bl1ndc4m3l/sdc-ntc-emulator/HANDOFF_SDC_NTC_Emulator.md

# Handoff: Wireless Room Sensor for Honeywell Home Smile SDC via NTC Emulation

> **⏰ Pending checks (user):**
> 1. **DevKit diode check:** Are there Schottky diodes (1N5819 or similar) between each USB-C VBUS and the 5 V rail on the clone board? This decides whether USB and RAC03 may be connected at the same time.
>
> Details under [Open points](#open-points-clarify-before-starting).

## Goal

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

## Installed hardware

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

Datasheets and manuals are kept locally in `datasheets/` (not in git, `*.pdf` is ignored). The authoritative SDC documents are the English Resideo set for the SDC3-40PM, revision R1020, valid for software V3.2:

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

The other German `SDC_*.pdf` files (2006–2008) are older revisions and only kept for reference.

## Context from the preliminary discussion

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

## Circuit (revision 3, PCB rev 2 after the independent review of 2026-09-30)

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

```
  LIVING ROOM                       HOME ASSISTANT                 BOILER ROOM
 ┌────────────────┐   Wi-Fi     ┌─────────────────┐  ESPHome API  ┌──────────────────────┐
 │ NSPanel-EU     │ ──────────▶ │ entity "Anzeige"│ ────────────▶ │ ESP32-S3 DevKitC-1   │
 │ (ESPHome)      │             └─────────────────┘               └──────────────────────┘

            ESP DOMAIN (RAC03 secondary / USB / PC)  ┆  SDC DOMAIN (floating, referenced to X5 only)
                                                     ┆
 230 V ─ fuse ─▶ RAC03 ─ 5 V ─▶ Q2 P-FET (reverse-polarity protection) ─ +5V
                              ┌───────────────────────────────────────────┘
                              ├─▶ DevKit 5V pin      ┆
                              ├─▶ iso DC/DC in ══════╪═▶ TMR 1-0511  5V = VDD_ISO ─┬─▶ AD5272 VDD
                              │                      ┆                             └─▶ ISO1540 side 2
      DevKit 3V3 ─▶ ISO1540 side 1                   ┆
      GPIO8/9 SDA/SCL ─▶ ISO1540 ════════════════════╪═▶ SDA2/SCL2 ─▶ AD5272 (addr 0x2F)
                              └─▶ relay coil ◀─ MOSFET ◀─ GPIO4 "ENABLE" (pull-down)
                                   ║            └─ 10k/20k divider ─▶ GPIO5 "SENSE" (LOW = coil on)
                                   ║ (coil/contact isolation)
              ┌─ relay (G5V-2, both poles in parallel, gold contacts) ───────────┐
 X6-6 (VE1) ──┤ COM                                                              │
              │   NO (energised) ── R_series 18.2 kΩ 0.1 % ── W ┤AD5272 50k├ A ──┼──┐
              │   NC (no power)  ── R_failsafe 24.9 kΩ 0.1 % ────────────────────┼──┤
              └──────────────────────────────────────────────────────────────────┘  │
 X5-2…12 (GND, never X5-1) ─────────────────────────────── GND_ISO (AD5272, ISO1540-2) ┘
```

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

**Gap on the PCB: ≥ 1.40 mm copper-to-copper**, measured on the finished board by `tools/check_isolation.py` (build fails below 1.0 mm).
- **Rev 3:** the gap is one straight line through PS1, U1 and U3, plus one step around the relay contacts. The Traco TMR 1-0511 (SIP-6) has its input at one end and its output at the other, with 3.6 mm of copper between them.
- **History:** the earlier TEM 2-0511 (DIP-24) put −Vin (pin 12) next to +Vout (pin 11).
  - That forced a notch into the gap; its tightest spot was 1.15 mm in rev 2.
  - Rev 1 claimed "≥ 1 mm" but actually had 0.40 mm there (found by the review).
  - Since rev 2 the router keeps whole tracks, not just their centre lines, inside their domain.

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

### Why each part is there

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

### Bill of materials

| Part | Purpose | Note |
|---|---|---|
| ESP32-S3-DevKitC-1 (WROOM-1 N16R8) | Receives room temp., drives rheostat and relay | powered via its 5V pin from the RAC03 |
| AD5272BRMZ-50 (MSOP-10, soldered directly on the PCB) | digital rheostat, 50 kΩ, 1024 steps, I2C | needs 1 µF on EXT_CAP, 100 nF on VDD, RESET tied to VDD, ADDR → GND = I2C address 0x2F |
| Resistor 18.2 kΩ, 0.1 %, ≤ 25 ppm/K, THT | R_series (R9) | |
| Resistor 24.9 kΩ, 0.1 %, ≤ 25 ppm/K, THT | R_failsafe (R10) | value = NTC resistance at the SDC day setpoint, minus the +0.5 K display offset |
| **Omron G5V-2-H1 5VDC** (DPDT, both poles in parallel) | fail-safe switch-over | gold-alloy contacts, coil 30 mA / 167 Ω; Reichelt; PCB holes 1.0 mm as Omron recommends |
| AO3400A, 100 kΩ, 100 Ω, 1N4148W | relay driver | |
| 10 kΩ + 20 kΩ | relay sense divider to GPIO5 | |
| AO3401A P-FET | reverse-polarity protection | |
| ISO1540 (TI) or ADuM1250 (ADI) | bidirectional I2C isolator | each side 3.0–5.5 V; 100 nF decoupling per side |
| Isolated DC/DC: **Traco TMR 1-0511** (since PCB rev 3; replaces the TEM 2-0511) | powers the SDC domain: VDD_ISO = 5 V for AD5272, ISO1540 side 2, ISO7721 side 2, service port J5 | See the notes below the table. |
| LED + 1.5 kΩ on VDD_ISO | "SDC domain powered" indicator | ~2 mA; always fitted |

TMR 1-0511 details:
- **Electrical:** 4.5–9 V in, **regulated** 5 V ±1 % out, 200 mA, **no minimum load** (no preload resistor needed).
- **Input current:** 40 mA at no load, 76 % efficiency.
- **Isolation:** 1500 VDC, 50 pF.
- **Ripple:** ≤ 110 mVpp; up to 1680 µF capacitive load allowed.
- **Package:** SIP-6, with the input (pins 1/2) at one end and the output (pins 4/6) at the other.
- **Temperature:** −40 … +95 °C. The TEM 5 V models were only rated to +60 °C, which mattered in a boiler room.
- **Decoupling:** 10 µF on each side; 10 µF + 100 nF at the AD5272. No LDO needed.
- **Datasheet:** `datasheets/TMR1_datasheet.pdf`.
| 2 × 2.7 kΩ (ESP side), 2 × 4.7 kΩ (SDC side) | I2C pull-ups on **both** sides of the isolator | ESP side to 3V3: 2.7k so the ISO1540 side 1 sinks ≥ 0.5 mA at its 0.8 V low level. SDC side to VDD_ISO. |
| Electrolytic capacitor 470 µF / 10 V | 5 V bulk buffer for Wi-Fi current peaks | RAC03 allows up to 7500 µF |
| Ceramic capacitor 10 µF / 25 V X7R, 1206 (C9) | parallel to the elco: low ESR against RAC03 switching ripple and fast current edges | 25 V/1206 because of DC-bias derating; a film cap of 10 µF would be far too large |
| Recom RAC03-05SER/277 | isolated 5 V supply | see assessment below |
| Slow-blow fuse + in-line holder | mains-side protection | Recom recommends a slow-blow type |
| Wago lever terminals (mains), 2 × 2-pin PCB screw terminals (5 V in, SDC) | wiring | mains only on the Wago side, never on the PCB |
| Enclosure | | mains section and PCB section separated; strain relief |

### Digital rheostat: AD5272 vs. alternatives (reviewed 2026-09-29)

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

Absolute tolerance is less critical, since a one-time calibration can remove it.

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

### PCB

**Designed (rev 3, 2026-10-01): [hardware/sdc-ntc-emulator/](hardware/sdc-ntc-emulator/README.md).**
- KiCad 9, 2 layers, 104 × 76 mm.
- ERC and DRC clean, schematic parity OK, isolation gap check ≥ 1.40 mm.
- Rev 3 adds the TMR 1-0511, the isolated service-port UART (J5), power and relay LEDs, and the expansion header J6.
- JLC Gerber zip and BOM in `production/`, generated from `tools/design.py` by `tools/build.py`.
- Choices made during layout:
  - Relay **Omron G5V-2-H1 5VDC** with both poles **in parallel**: COM 4+13, NC 6+11, NO 8+9, coil 1/16, gold-alloy contacts, 30 mA coil.
  - GPIO4 = relay, GPIO5 = relay sense, GPIO8/9 = I2C.
  - R_failsafe and R_series are THT 0.1 % parts, so they are easy to swap.
  - The AD5272's A and VSS pins connect to GND_ISO by a short trace under the chip body (under solder mask, no vias there).
- Before ordering, check the points in the README: PS1 footprint, terminal orientation, R10 value. DevKit row spacing is 25.1 mm (measured).

- **No mains on the PCB.** The RAC03-05SER/277 is a potted module (50.3 × 50.3 × 11 mm) with **flying leads** on input and output. It sits next to the PCB in the enclosure, fixed with a clip, strap or adhesive pad.
  - Its input leads go to a fused mains terminal (e.g. an in-line fuse holder with a slow-blow fuse + Wago lever terminals), in their own section of the enclosure.
  - Its output leads go to a 2-pin 5 V screw terminal on the PCB.
  - So the PCB is SELV only, and no 6 mm mains clearances are needed on it.
- **Own PCB from JLC (bare board, hand-soldered)** rather than perfboard, for clean isolation gaps:
  - Two zones: **ESP domain** and **SDC domain**.
  - ≥ 1.40 mm copper gap across the ISO1540 / ISO7721 / TMR 1-0511 / relay barrier (measured by `tools/check_isolation.py`), with no copper crossing it except through those parts.
- **Hand-soldering friendly:**
  - Passives 0805/1206; ISO1540 in SOIC-8; MOSFET in SOT-23.
  - Relay and TMR 1-0511 (SIP-6) through-hole.
  - AD5272 MSOP-10 is the only fine-pitch part. Wide power tracks stay out of its area, and no vias sit under it.
- DevKit on female headers (removable). Screw terminals: 5 V in (from RAC03), 2-pin to the SDC (X6-6 / X5-2…12, **never X5-1**, which is the T2B data bus).
- Silkscreen text ≥ 1.0 mm / 0.15 mm (JLC minimum).
- **Enclosure:**
  - Mains section (RAC03 input, fuse, terminals) separated from the PCB section, e.g. by a partition or at least clearly apart with fixed wiring.
  - Strain relief for the mains cable and the SDC cable.

### GPIO notes for the ESP32-S3 N16R8

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

### AD5272 supply voltage (settled by the VE1 measurement: U_max ≈ 1.7 V)

The voltage on terminals A/W must stay between GND and VDD. Worst case is the highest resistance: U_max = U0 × 68 kΩ / (68 kΩ + R_pull), with R_pull = 20 kΩ × (U0 / U20 − 1).
- **Decided: VDD_ISO = 5 V** from the isolated DC/DC (Traco TMR 1-0511 since rev 3). That gives the most headroom. Measured: U_max ≈ 1.7 V, so it is confirmed with a wide margin.
- The ISO1540 handles the level shift to the ESP32's 3V3, so no extra level shifter is needed.

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

### NTC 20 resistance (from service manual EN2H-0221GE51 R1020, ch. 8.2.1)

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

### Power supply assessment: Recom RAC03-05SER/277

**Suitable, with caveats.**
- **Good:** 3 kVAC isolation, EN 60335-1 (household appliances) certified, leakage ≤ 10 µA, OVP and short-circuit protection, −40 … +75 °C at full load, 85–305 VAC input.
- **Current budget:** 600 mA at 5 V. ESP32-S3 Wi-Fi TX peaks ≈ 350–500 mA at 5 V incl. the DevKit regulator's losses, plus relay ~30 mA. That is enough, but not generous, so add the 470 µF bulk capacitor. Average draw ≈ 100 mA. Keep the DevKit's RGB LED off.
- **Obsolescence:** the datasheet says "not recommended for new designs, last time buy 31 Mar 2026". Fine for this one unit, but a replacement would be a different part. The options are in the PCB README ("5 V supply alternatives"):
- **Kit default:** any certified USB-C charger (5 V ≥ 2 A) into the board's USB-C input J7 (since PCB rev 3). No mains wiring by the user.
- **Plug-in adapter with wires into J3:** Mean Well SGA12E05-P1J (5 V / 2.4 A).
- **Same concept as the RAC03:** Recom RAC05-05SK/277/W (wire leads, 1 A).
- **DIN rail:** Mean Well HDR-15-5.
- **Mains wiring (by a qualified person):** It is a potted module with flying leads, so it stays off the PCB (see PCB). It still needs a slow-blow input fuse, a closed enclosure and strain relief. Feed it from its own fused supply or socket. Do not tap the SDC's L/N terminals.
- **Isolation concept:** The RAC03 isolates from mains. The I2C isolator + iso DC/DC (revision 3) additionally separate the ESP32 from the SDC sensor ground.
- **Current budget with the isolation (tight):**
  - **The isolated DC/DC:** the TEM 2-0511 drew 80 mA even without load. Since PCB rev 3, the TMR 1-0511 draws ≈ 40 mA at no load, plus ≈ 30 mA for the SDC-side load at 76 % efficiency, so ≈ 50–70 mA.
  - **Peak:** ESP32-S3 Wi-Fi ≈ 350–500 mA + relay ≈ 30 mA + DC/DC ≈ 60 mA + LEDs ≈ 3 mA ≈ **445–595 mA vs. the RAC03's 600 mA**. This was 460–610 mA with the TEM.
  - **Average:** ≈ 180 mA. The TX peaks are short and the RAC03's over-current limit only starts at 120–190 % (≥ 720 mA; the 105–150 % in the datasheet is the over-voltage clamp), so this works, but only with the **470 µF bulk capacitor** (RAC03 allows up to 7500 µF; 1000 µF is also fine). Further headroom: disable Bluetooth, reduce ESPHome `wifi: output_power` (e.g. 15 dB), keep the RGB LED off. If the ESP32 shows brown-out resets: move to a Mean Well IRM-05-5 (1 A).

## Failure modes and fail-safe behaviour

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

## Safety

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

## Software tasks for Claude Code

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

## Setup on the SDC controller

### Operating the SDC: technician level and parameters (service manual ch. 5.1.2.9 / 5.2)

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

## Open points (clarify before starting)

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

  At commissioning: tune the offset against the panel, and check that the fail-safe state (relay off → 24.9 kΩ) shows ≈ 21 °C on the SDC.
- [ ] **⏰ PENDING (user): DevKit clone diode check.** The official ESP32-S3-DevKitC-1 (schematic in `datasheets/`) has a Schottky diode 1N5819 (D1, D7) from each USB-C VBUS to the 5 V rail. It blocks back-feed from the RAC03 into the PC. Check on the clone: look for a small diode (SOD-123, marking e.g. "S4"/"SL" or similar) next to each USB-C port. Alternatively measure with the multimeter in diode mode from the VBUS pin of each port to the 5V header pin: ~0.2–0.4 V in one direction and open in the other = diode present. **If missing:** unplug the RAC03 (or disconnect the 5 V pin) whenever USB is connected.
- [x] Isolated DC/DC: **Traco TMR 1-0511** since PCB rev 3 (5 V → 5 V regulated, 1 W, no minimum load; datasheet `datasheets/TMR1_datasheet.pdf`). VDD_ISO = 5 V, no LDO.
  - It replaces the TEM 2-0511, whose DIP-24 pinout forced a notch into the isolation gap.
  - The TEM is now unused; it stays as a spare for something else.
  - At assembly: VDD_ISO = 5.0 V ±1 %.
- [ ] **SDC service port pinout (user).** The 6-pin socket (~1.0 mm pitch) behind the flap above the day/night buttons carries a proprietary 9600 baud protocol at 5 V logic.
  - Protocol: frames end with `21 0A 0A`, checksum CRC-16/KERMIT.
  - An earlier decoder is in `D:\Development\ESPHome\Heizungscontroller.yaml`, RX only. It already decodes outside, boiler, flow, hot water and solar temperatures, burner starts and status.
  - PCB rev 3 has an isolated UART for it on J5, the measurement procedure is in `hardware/sdc-ntc-emulator/README.md` ("Service port"). Still to find out:
    1. which pin is GND, the SDC's TX, its RX, and 5 V (if any);
    2. whether the port GND has continuity to X5-2;
    3. whether a record carries the VE1 reading. That would allow an end-to-end check of the emulated temperature.
  - Sending is possible but untested. It might later replace the analog VE1 path.
- [ ] SDC day room setpoint? It determines the R_failsafe value (24.9 kΩ assumes 21 °C displayed, including the +0.5 K SDC offset).
- [x] Sonoff panel: NSPanel-EU (original NSPanel, Wi-Fi, black) with custom ESPHome firmware.
- [x] Home Assistant is available and is the data path.
- [x] HA entity: the panel appears in Home Assistant as **"Anzeige"**. Its temperature reading is available and checked as correct. For the ESPHome `homeassistant` sensor, look up the exact `entity_id` (e.g. `sensor.anzeige_…`) in HA.
- [x] Exact NTC 20k characteristic: see table above (10–30 °C). The full range is in the service manual, ch. 8.2.1.

---

*A German version of this document ([HANDOFF_SDC_NTC_Emulator.de.md](HANDOFF_SDC_NTC_Emulator.de.md)) is kept for reference but is outdated.*
