bl1ndc4m3l/sdc-ntc-emulator/pcb/production/sdc-ntc-emulator-bottom.png

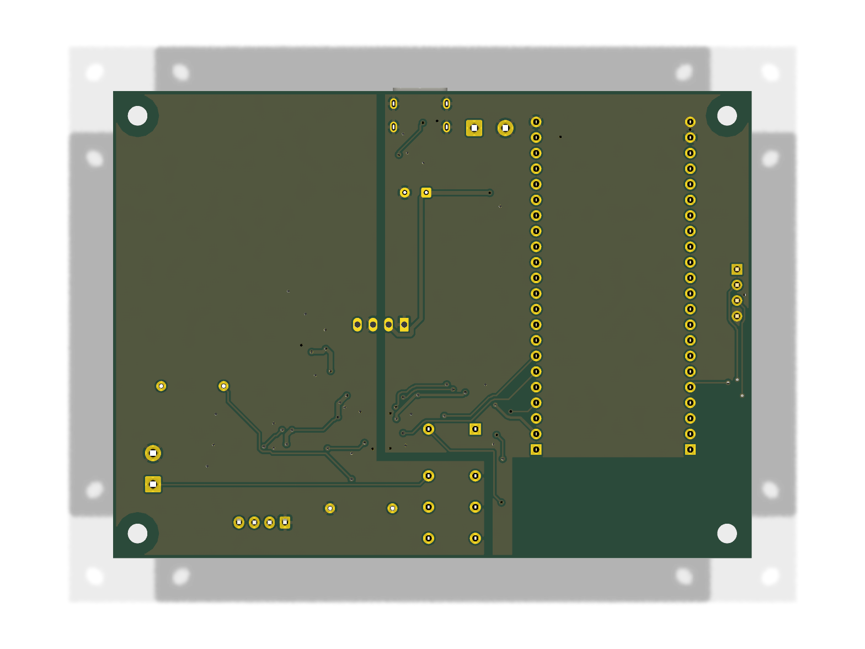
pcb/production/sdc-ntc-emulator-bottom.png
