bl1ndc4m3l/sdc-ntc-emulator/pcb/production/sdc-ntc-emulator-schematic.pdf

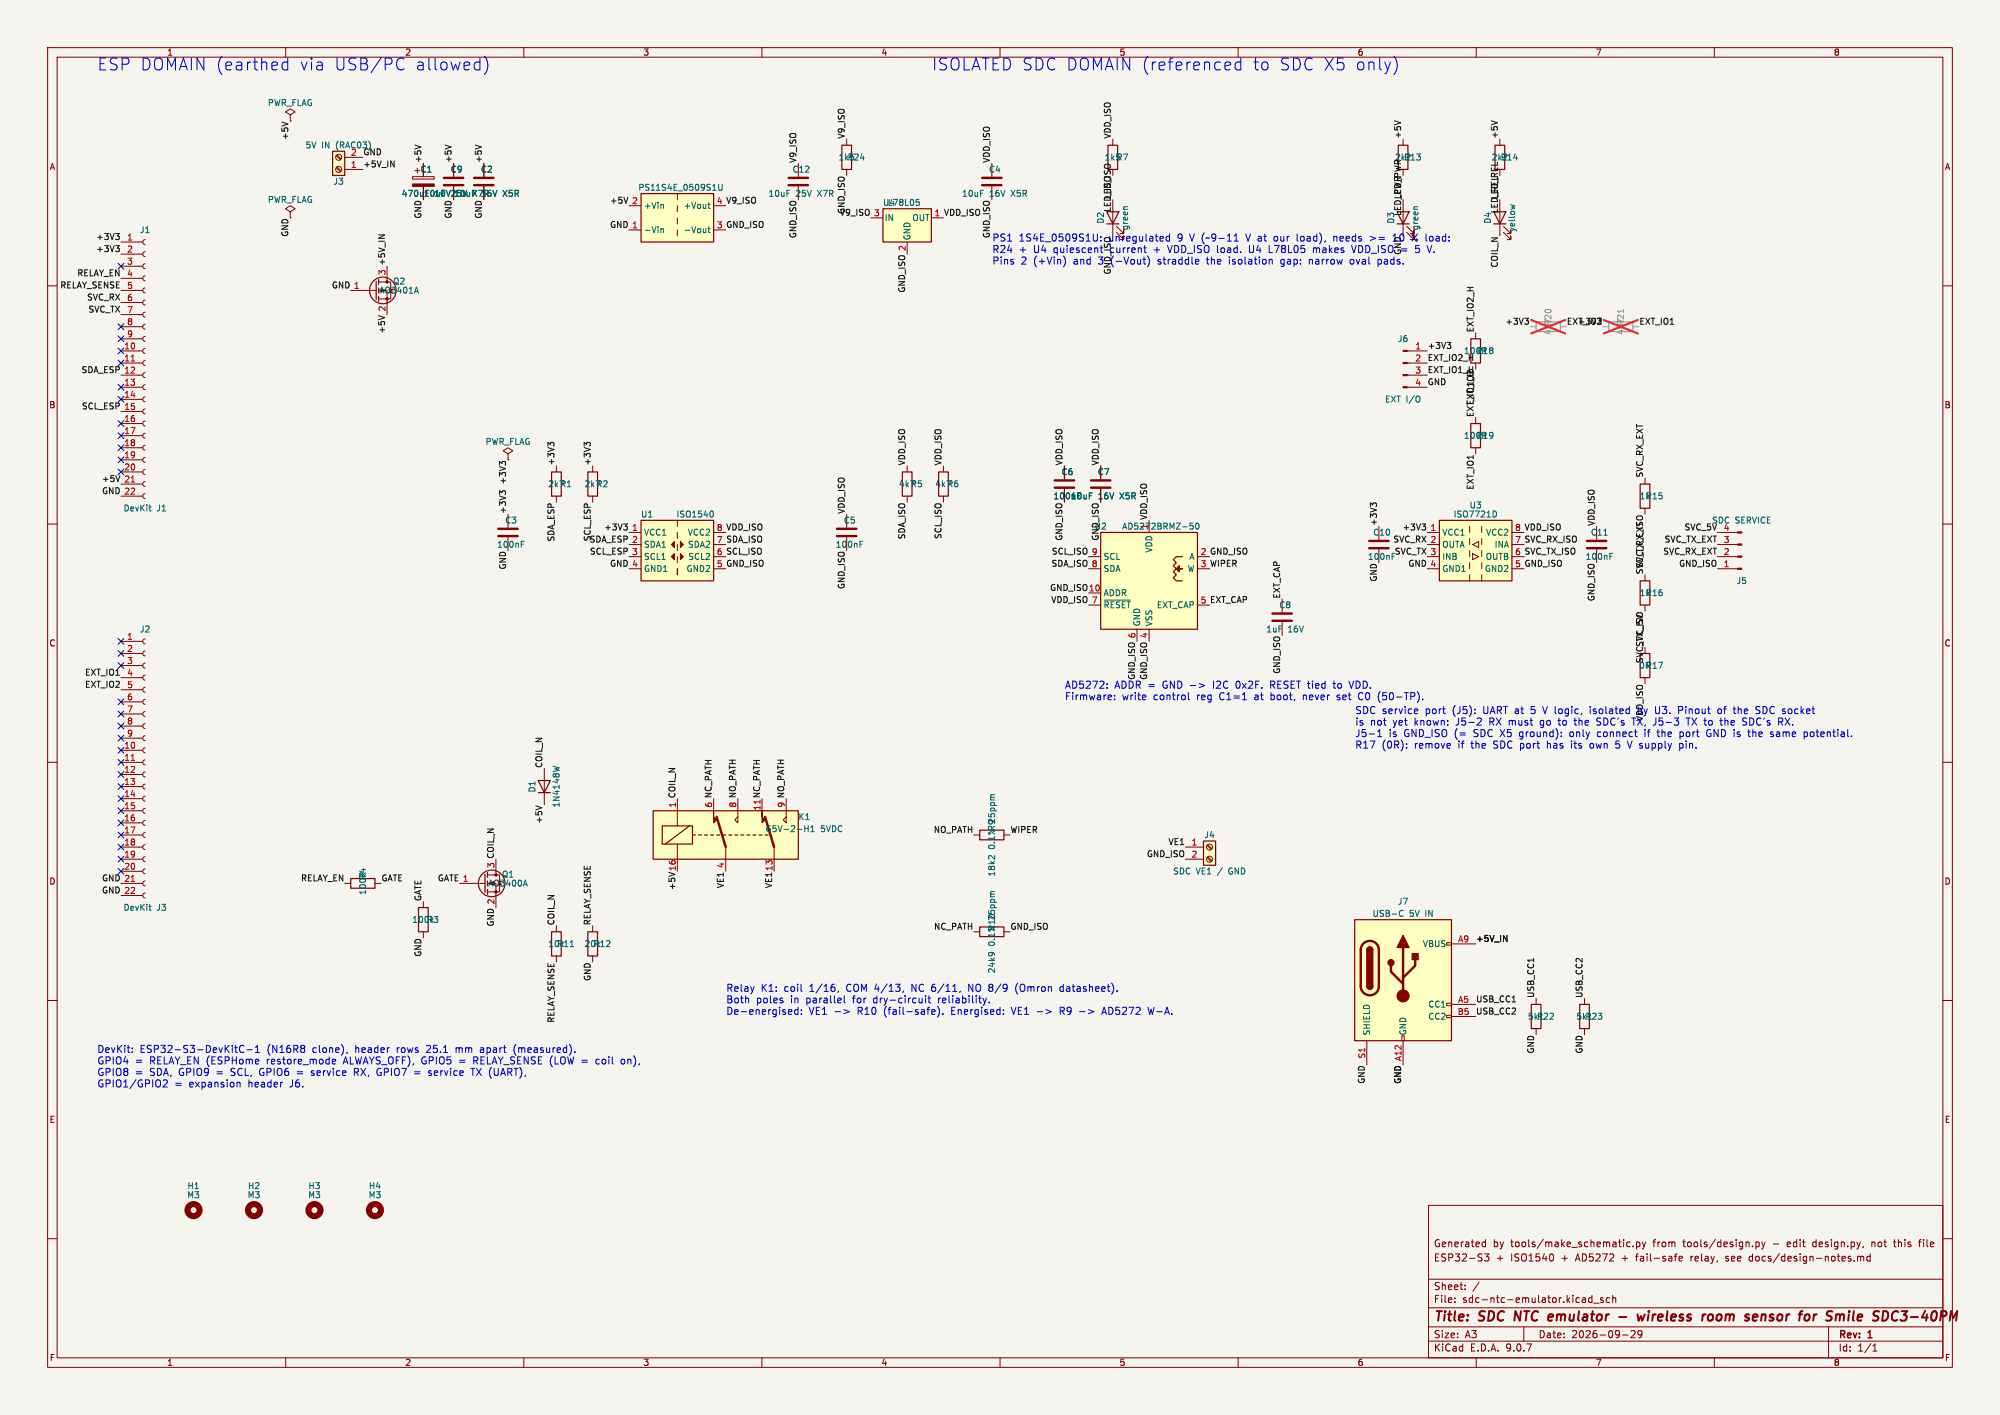
[picture p3: page 1]

ESP DOMAIN (earthed via USB/PC allowed)

Id: 1/1 Title: SDC NTC emulator - wireless room sensor for Smile SDC3-40PM
