bl1ndc4m3l/sdc-ntc-emulator/pcb/sdc-ntc-emulator.kicad_pcb

## KiCad design pcb/sdc-ntc-emulator.kicad_pcb (2026-10-04)

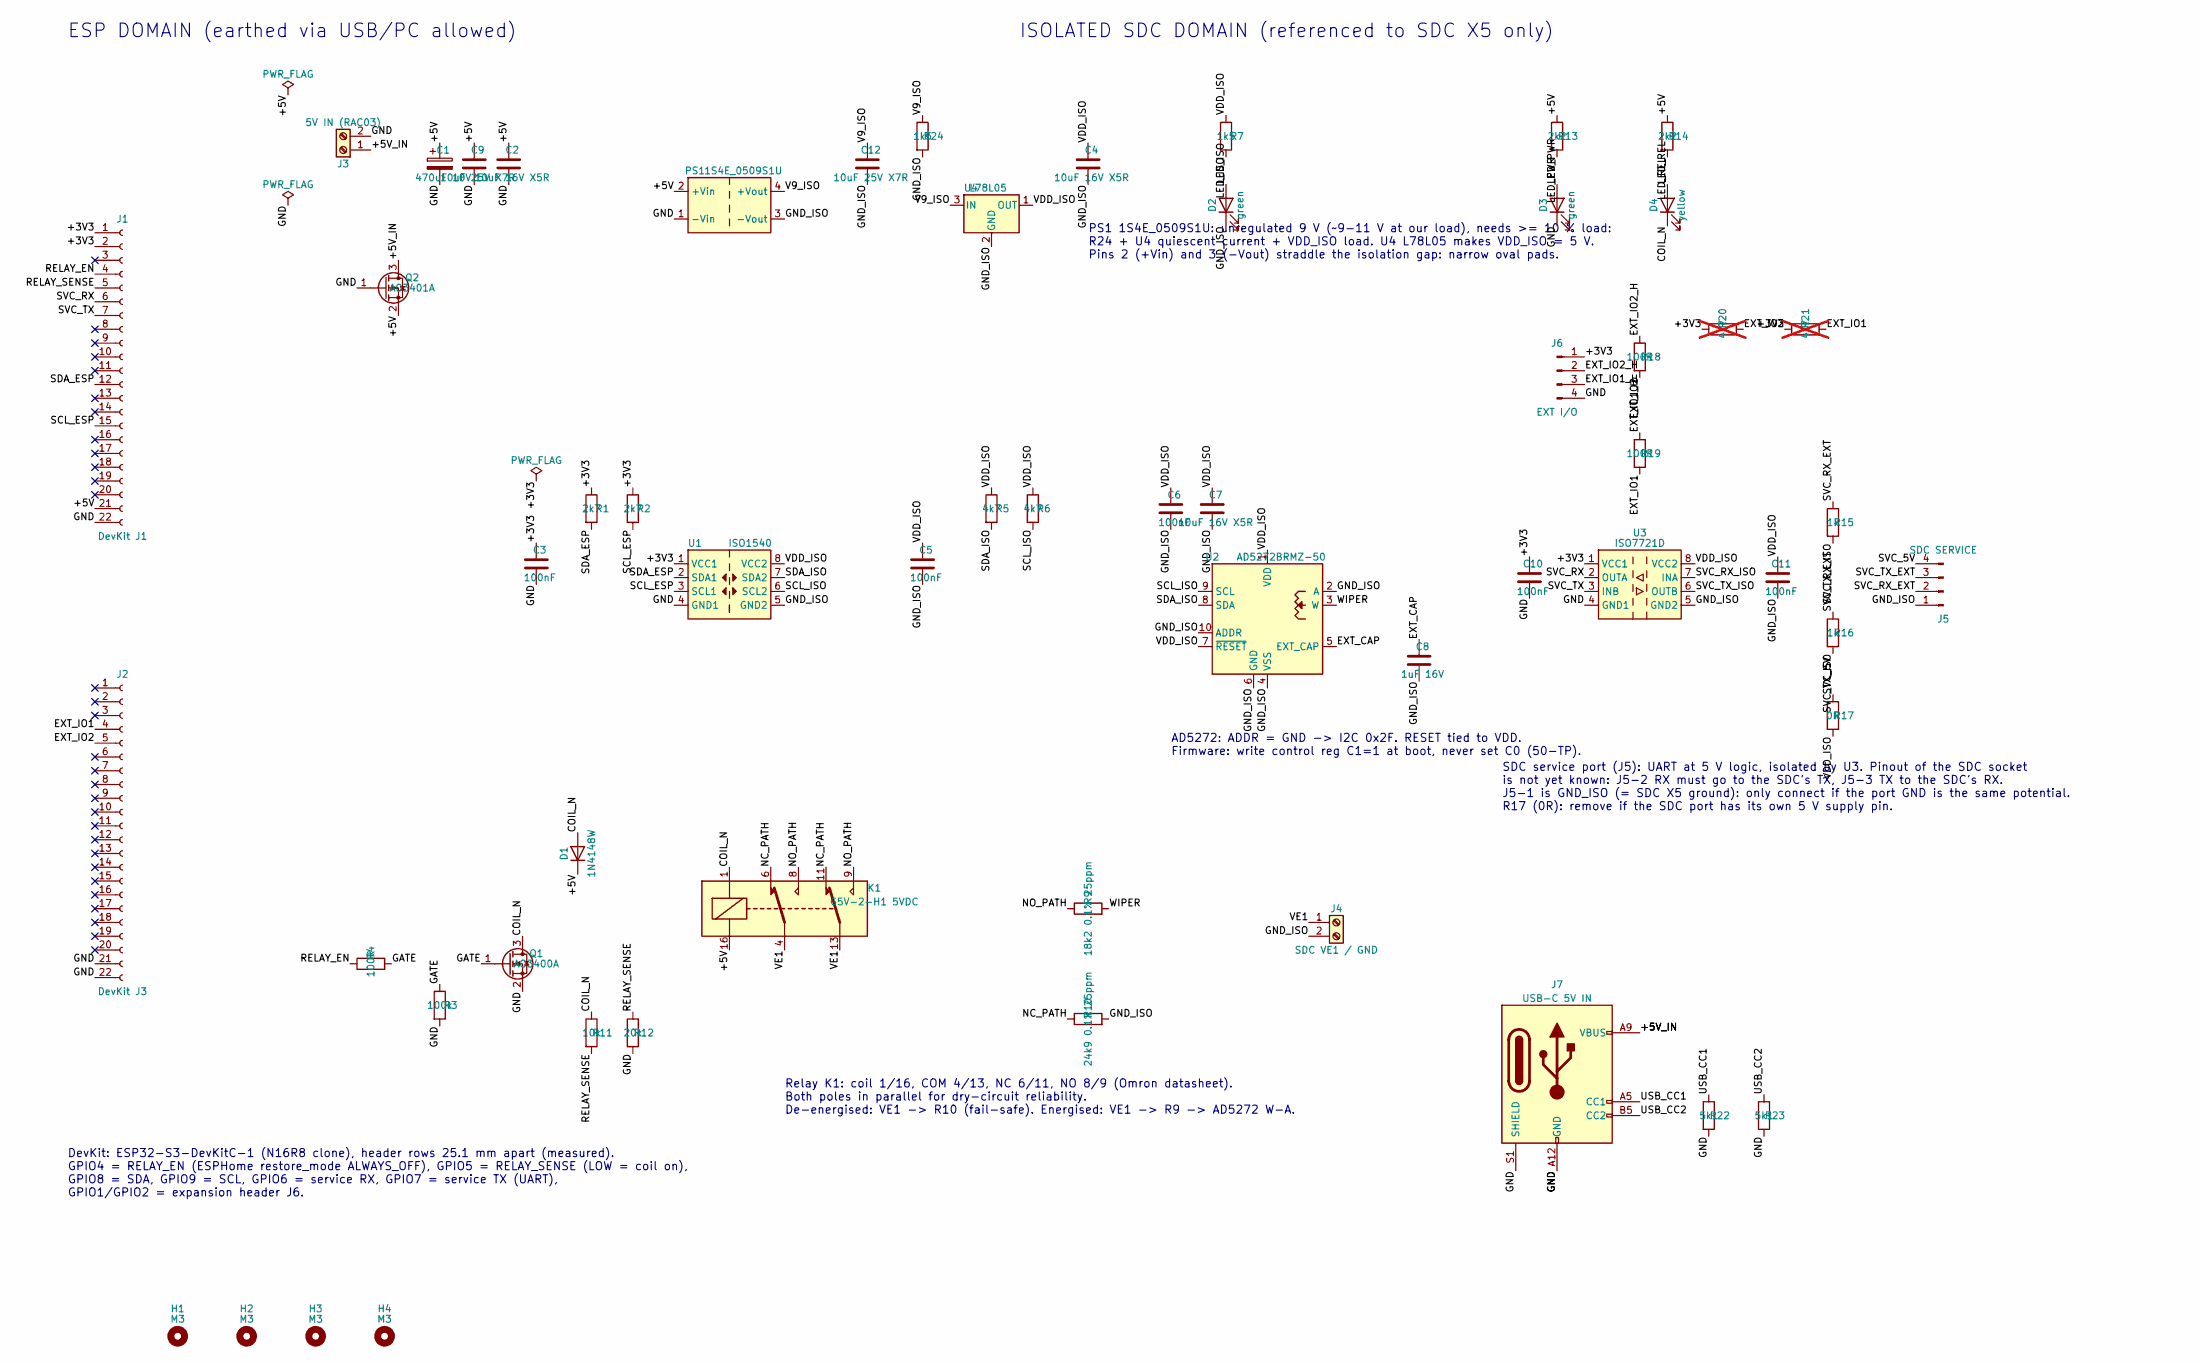
[picture p4: schematic sdc-ntc-emulator.kicad_sch, SDC NTC emulator - wireless room sensor for Smile SDC3-40PM]

Parts:
C1: 470uF 10V; CP_Radial_D8.0mm_P3.50mm; MPN EEU-FR1A471
C2, C4, C7: 10uF 16V X5R; C_0805_2012Metric_Pad1.18x1.45mm_HandSolder; MPN CC0805KRX5R7BB106
C3, C5, C6, C10, C11: 100nF; C_0805_2012Metric_Pad1.18x1.45mm_HandSolder; MPN CL21B104KBCNNNC
C8: 1uF 16V; C_0805_2012Metric_Pad1.18x1.45mm_HandSolder; MPN GRM219R71E105KA88D
C9, C12: 10uF 25V X7R; C_1206_3216Metric_Pad1.33x1.80mm_HandSolder; MPN GRM31CR71E106MA12L
D1: 1N4148W; D_SOD-123; MPN 1N4148W-7-F
D2, D3: green; LED_0805_2012Metric_Pad1.15x1.40mm_HandSolder; MPN LTST-C171GKT
D4: yellow; LED_0805_2012Metric_Pad1.15x1.40mm_HandSolder; MPN LTST-C171YKT
H1, H2, H3, H4: M3; MountingHole_3.2mm_M3
J1: DevKit J1; PinSocket_1x22_P2.54mm_Vertical; MPN PPTC221LFBN-RC
J2: DevKit J3; PinSocket_1x22_P2.54mm_Vertical; MPN PPTC221LFBN-RC
J3: 5V IN (RAC03); TerminalBlock_Phoenix_MKDS-1,5-2-5.08_1x02_P5.08mm_Horizont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; MPN 1715721
J4: SDC VE1 / GND; TerminalBlock_Phoenix_MKDS-1,5-2-5.08_1x02_P5.08mm_Horizont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; MPN 1715721
J5: SDC SERVICE; JST_XH_B4B-XH-A_1x04_P2.50mm_Vertical; MPN B4B-XH-A(LF)(SN)
J6: EXT I/O; PinHeader_1x04_P2.54mm_Vertical; MPN 61300411121
J7: USB-C 5V IN; USB_C_Receptacle_GCT_USB4125-xx-x-0190_6P_TopMnt_Horizontal; MPN USB4125-GF-A-0190
K1: G5V-2-H1 5VDC; Relay_DPDT_Omron_G5V-2; MPN G5V-2-H1 DC5
PS1: 1S4E_0509S1U; Converter_DCDC_TRACO_TME_03xxS_05xxS_12xxS_Single_THT; MPN 1S4E_0509S1U
Q1: AO3400A; SOT-23; MPN AO3400A
Q2: AO3401A; SOT-23; MPN AO3401A
R1, R2: 2k7; R_0805_2012Metric_Pad1.20x1.40mm_HandSolder; MPN RC0805FR-072K7L
R3: 100k; R_0805_2012Metric_Pad1.20x1.40mm_HandSolder; MPN RC0805FR-07100KL
R4, R18, R19: 100R; R_0805_2012Metric_Pad1.20x1.40mm_HandSolder; MPN RC0805FR-07100RL
R5, R6: 4k7; R_0805_2012Metric_Pad1.20x1.40mm_HandSolder; MPN RC0805FR-074K7L
R7, R24: 1k5; R_0805_2012Metric_Pad1.20x1.40mm_HandSolder; MPN RC0805FR-071K5L
R9: 18k2 0.1% 25ppm; R_Axial_DIN0207_L6.3mm_D2.5mm_P10.16mm_Horizontal; MPN YR1B18K2CC
R10: 24k9 0.1% 25ppm; R_Axial_DIN0207_L6.3mm_D2.5mm_P10.16mm_Horizontal; MPN YR1B24K9CC
R11: 10k; R_0805_2012Metric_Pad1.20x1.40mm_HandSolder; MPN RC0805FR-0710KL
R12: 20k; R_0805_2012Metric_Pad1.20x1.40mm_HandSolder; MPN RMCF0805FT20K0
R13, R14: 2k2; R_0805_2012Metric_Pad1.20x1.40mm_HandSolder; MPN RC0805FR-072K2L
R15, R16: 1k; R_0805_2012Metric_Pad1.20x1.40mm_HandSolder; MPN RC0805FR-071KL
R17: 0R; R_0805_2012Metric_Pad1.20x1.40mm_HandSolder; MPN RC0805JR-070RL
R20, R21: 4k7; R_0805_2012Metric_Pad1.20x1.40mm_HandSolder; MPN RC0805FR-074K7L; not fitted
R22, R23: 5k1; R_0805_2012Metric_Pad1.20x1.40mm_HandSolder; MPN CR0805-FX-5101ELF
U1: ISO1540; SOIC-8_3.9x4.9mm_P1.27mm; MPN ISO1540DR
U2: AD5272BRMZ-50; MSOP-10_3x3mm_P0.5mm; MPN AD5272BRMZ-50
U3: ISO7721D; SOIC-8_3.9x4.9mm_P1.27mm; MPN ISO7721DR
U4: L78L05; SOT-89-3; MPN L78L05ACUTR

Connections:
/+3V3: C3.1, C10.1, J1.1, J1.2, J6.1, R1.1, R2.1, R20.1, R21.1, U1.1 (VCC1), U3.1 (VCC1)
/+5V: C1.1, C2.1, C9.1, D1.1 (K), J1.21, K1.16, PS1.2 (+Vin), Q2.2 (S), R13.1, R14.1
/+5V_IN: J3.1, J7.A9 (VBUS), J7.B9 (VBUS), Q2.3 (D)
/COIL_N: D1.2 (A), D4.1 (K), K1.1, Q1.3 (D), R11.1
/EXT_CAP: C8.1, U2.5 (EXT_CAP)
/EXT_IO1: J2.4, R19.2, R21.2
/EXT_IO1_H: J6.3, R19.1
/EXT_IO2: J2.5, R18.2, R20.2
/EXT_IO2_H: J6.2, R18.1
/GATE: Q1.1 (G), R3.1, R4.2
/GND: C1.2, C2.2, C3.2, C9.2, C10.2, D3.1 (K), J1.22, J2.21, J2.22, J3.2, J6.4, J7.A12 (GND), J7.B12 (GND), J7.S1 (SHIELD), PS1.1 (-Vin), Q1.2 (S), Q2.1 (G), R3.2, R12.2, R22.2, R23.2, U1.4 (GND1), U3.4 (GND1)
/GND_ISO: C4.2, C5.2, C6.2, C7.2, C8.2, C11.2, C12.2, D2.1 (K), J4.2, J5.1, PS1.3 (-Vout), R10.2, R24.2, U1.5 (GND2), U2.2 (A), U2.4 (VSS), U2.6 (GND), U2.10 (ADDR), U3.5 (GND2), U4.2 (GND)
/LED_ISO: D2.2 (A), R7.2
/LED_PWR: D3.2 (A), R13.2
/LED_REL: D4.2 (A), R14.2
/NC_PATH: K1.6, K1.11, R10.1
/NO_PATH: K1.8, K1.9, R9.1
/RELAY_EN: J1.4, R4.1
/RELAY_SENSE: J1.5, R11.2, R12.1
/SCL_ESP: J1.15, R2.2, U1.3 (SCL1)
/SCL_ISO: R6.2, U1.6 (SCL2), U2.9 (SCL)
/SDA_ESP: J1.12, R1.2, U1.2 (SDA1)
/SDA_ISO: R5.2, U1.7 (SDA2), U2.8 (SDA)
/SVC_5V: J5.4, R17.1
/SVC_RX: J1.6, U3.2 (OUTA)
/SVC_RX_EXT: J5.2, R15.1
/SVC_RX_ISO: R15.2, U3.7 (INA)
/SVC_TX: J1.7, U3.3 (INB)
/SVC_TX_EXT: J5.3, R16.1
/SVC_TX_ISO: R16.2, U3.6 (OUTB)
/USB_CC1: J7.A5 (CC1), R22.1
/USB_CC2: J7.B5 (CC2), R23.1
/V9_ISO: C12.1, PS1.4 (+Vout), R24.1, U4.3 (IN)
/VDD_ISO: C4.1, C5.1, C6.1, C7.1, C11.1, R5.1, R6.1, R7.1, R17.2, U1.8 (VCC2), U2.1 (VDD), U2.7 (~RESET), U3.8 (VCC2), U4.1 (OUT)
/VE1: J4.1, K1.4, K1.13
/WIPER: R9.2, U2.3 (W)

Notes on the sheet:
ESP DOMAIN (earthed via USB/PC allowed)
ISOLATED SDC DOMAIN (referenced to SDC X5 only)
DevKit: ESP32-S3-DevKitC-1 (N16R8 clone), header rows 25.1 mm apart (measured). GPIO4 = RELAY_EN (ESPHome restore_mode ALWAYS_OFF), GPIO5 = RELAY_SENSE (LOW = coil on), GPIO8 = SDA, GPIO9 = SCL, GPIO6 = service RX, GPIO7 = service TX (UART), GPIO1/GPIO2 = expansion header J6.
SDC service port (J5): UART at 5 V logic, isolated by U3. Pinout of the SDC socket is not yet known: J5-2 RX must go to the SDC's TX, J5-3 TX to the SDC's RX. J5-1 is GND_ISO (= SDC X5 ground): only connect if the port GND is the same potential. R17 (0R): remove if the SDC port has its own 5 V supp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
Relay K1: coil 1/16, COM 4/13, NC 6/11, NO 8/9 (Omron datasheet). Both poles in parallel for dry-circuit reliability. De-energised: VE1 -> R10 (fail-safe). Energised: VE1 -> R9 -> AD5272 W-A.
AD5272: ADDR = GND -> I2C 0x2F. RESET tied to VDD. Firmware: write control reg C1=1 at boot, never set C0 (50-TP).
PS1 1S4E_0509S1U: unregulated 9 V (~9-11 V at our load), needs >= 10 % load: R24 + U4 quiescent current + VDD_ISO load. U4 L78L05 makes VDD_ISO = 5 V. Pins 2 (+Vin) and 3 (-Vout) straddle the isolation gap: narrow oval pads.

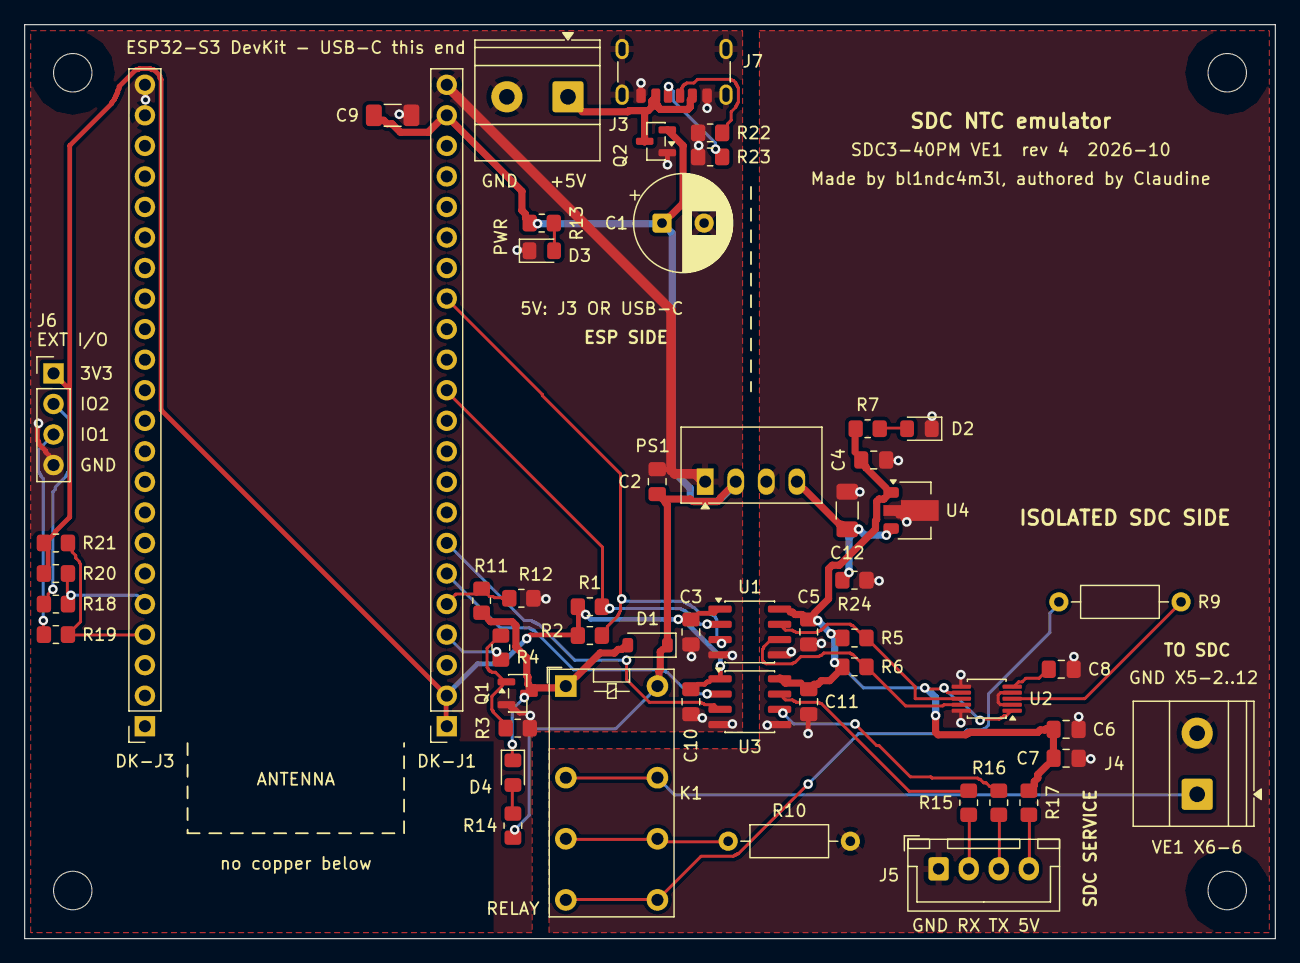
[picture p5: board sdc-ntc-emulator.kicad_pcb from above]

Board: 2 copper layers, 104.0 x 76.0 mm, 58 parts (0 on the bottom side), 36 nets.
