bl1ndc4m3l/sdc-ntc-emulator/(commit log)

2026-09-29 Translate handoff document to English
    Move the German version to HANDOFF_SDC_NTC_Emulator.de.md and mark it
    as outdated; the English version is now the maintained one.
2026-09-29 Record installed hardware and ignore PDFs
    Note the installed controller (SDC3-40PM) and the chosen power supply
    (Recom RAC03-05SER/277) in the handoff. Keep datasheet PDFs out of git.
2026-09-29 Record ESP32-S3 board and datasheet location in handoff
2026-09-29 Record SDC software V3.3 and mixed heating circuit 1
2026-09-29 Map VE measurements to SDC terminal plan (X5 GND, X6-7 VE2)
2026-09-29 Revise emulator circuit: fail-safe relay, R_series rationale, failure modes
    Add a relay that switches VE2 to a fixed setpoint resistor when the ESP32 is unpowered or in fail-safe, so the unpowered AD5272 is never back-powered by the SDC. Document why R_series (15.0k) is kept, assess the RAC03 supply, list failure scenarios and the pending VE2 measurement.
2026-09-29 Add I2C isolator and isolated supply for the AD5272 (circuit rev. 3)
    Separates the ESP32 domain from the SDC sensor ground so USB flashing works while installed; the isolator also level-shifts, making the AD5272 supply independent of the ESP32.
2026-09-29 Note DevKit diode check; document why the SDC bus supply is not used
2026-09-29 Review digital rheostat alternatives; add PCB notes; note pending Recom model
2026-09-29 Use Traco TEM 2-0511 for the isolated 5 V AD5272 supply
    Regulated 5 V output removes the LDO; note its 80 mA no-load draw in the RAC03 power budget.
2026-09-29 Add optional TEM 2-0511 preload resistor and VDD_ISO indicator LED
2026-09-29 Keep mains off the PCB: RAC03 has flying leads
2026-09-29 Record VE2 measurement (0 V with 20k) and diagnosis steps
2026-09-29 Switch to VE1: measured 1.3 V at 20k, SDC reads 25.5 C
    VE2/VE3 are dead on this SDC3-40PM. Derived ~65 uA measuring current, ~10.8k pull-up and 1.7 V worst-case terminal voltage, which confirms the 5 V AD5272 supply.
2026-09-29 Attribute +0.5 K VE1 offset to the SDC (test resistor verified at 20.0k)
2026-09-29 Add KiCad PCB for the SDC NTC emulator (rev 1)
    Schematic and 2-layer board (104 x 76 mm) generated from tools/design.py:
    ESP32-S3 DevKit sockets, ISO1540 + Traco TEM 2-0511 isolation, AD5272
    rheostat, Omron G5V-2 fail-safe relay with both poles in parallel.
    A small domain-restricted grid router keeps all copper out of the
    isolation gap. ERC/DRC clean incl. schematic parity; JLCPCB Gerber zip,
    BOM and renders in production/.
    [sdc-ntc-emulator-bom.csv, sdc-ntc-emulator.kicad_pcb, sdc-ntc-emulator.kicad_sch]
2026-09-29 PCB: fit the actual DevKit clone, fix antenna keep-out and GND split
    The clone is shorter than the official DevKitC-1 and its module antenna
    overhangs the DevKit edge right after pin 1, so the no-copper area now
    starts there. That cut the ESP ground pour in two; an explicit GND track
    from DevKit J1.22 to the TEM input ground reconnects it. Header row
    spacing is now one constant (DEVKIT_ROWS, still 25.4 mm pending a
    re-measurement).
    [sdc-ntc-emulator.kicad_pcb, sdc-ntc-emulator.kicad_sch]
2026-09-29 PCB: DevKit header rows 25.1 mm apart (measured)
    [sdc-ntc-emulator.kicad_pcb]
2026-09-29 PCB: add 10 uF ceramic (C9) parallel to the 5 V input elco
    [sdc-ntc-emulator-bom.csv, sdc-ntc-emulator.kicad_pcb, sdc-ntc-emulator.kicad_sch]
2026-09-29 PCB: move isolation gap right; C9 under DevKit at its 5V pin; C2 and R8 away from the TEM
    [sdc-ntc-emulator.kicad_pcb]
2026-09-30 PCB rev 2: apply the independent design review
    - Isolation gap 0.40 -> 1.15 mm (oval TEM pads, wider domain outlines,
    router keeps full track width inside its domain); new
    tools/check_isolation.py measures the real copper gap and fails the build
    below 1.0 mm.
    - Relay state sense (R11/R12 -> GPIO5) and reverse-polarity P-FET (Q2).
    - R9 15.0k -> 18.2k (27 C floor if the AD5272 fails), R10 24.3k -> 24.9k
    (SDC +0.5 K offset), R1/R2 4.7k -> 2.7k (ISO1540 side-1 sink current).
    - C3/C5 next to the ISO1540, relay holes 1.0 mm, AD5272 fan-out without
    wide tracks or vias under the chip, silkscreen >= 1.0 mm, X5-2..12 marking.
    - Handoff/README: corrected X5-1, RAC03 limits, row spacing, LDO/p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
    [sdc-ntc-emulator-bom.csv, sdc-ntc-emulator.kicad_pcb, sdc-ntc-emulator.kicad_sch]
2026-09-30 Add manufacturer part numbers and DigiKey BOM-Manager upload file
    [sdc-ntc-emulator-digikey-order.csv, sdc-ntc-emulator.kicad_pcb, sdc-ntc-emulator.kicad_sch]
2026-09-30 Add Mouser BOM-Tool upload file
    [sdc-ntc-emulator-mouser-order.csv]
2026-10-04 PCB rev 3: TMR 1-0511 isolated supply, DigiKey-verified BOM
    - PS1 Traco TMR 1-0511 (SIP-6) replaces the TEM 2-0511; straight isolation gap >= 1.40 mm
    - Parts that were obsolete, backordered or not stocked at DigiKey replaced by stocked equivalents
    - DigiKey upload file carries DigiKey part numbers; quantities follow DigiKey price breaks, spares only where useful
    [sdc-ntc-emulator-bom.csv, sdc-ntc-emulator-digikey-order-3x.csv, sdc-ntc-emulator-digikey-order.csv, sdc-ntc-emulator-mouser-order-3x.csv, sdc-ntc-emulator-mouser-order.csv, sdc-ntc-emulator.kicad_pcb, sdc-ntc-emulator.kicad_sch]
2026-10-04 PCB rev 4; restructure for public release
    PCB rev 4: Gaptec 1S4E_0509S1U + L78L05 replace the TMR 1-0511 as the
    isolated supply (isolation gap 1.14 mm, ERC/DRC clean).
    Repository layout for publication:
    - hardware/sdc-ntc-emulator/ -> pcb/, handoff -> docs/design-notes.md
    - firmware/ with pin map and plan (firmware not written yet)
    - top-level README, CERN-OHL-S-2.0 (hardware, docs) and
    GPL-3.0-or-later (pcb/tools, firmware)
    - build scripts take KiCad paths from environment variables
    - schematic PDF published; datasheets and local files git-ignored
    [sdc-ntc-emulator-bom.csv, sdc-ntc-emulator-digikey-order-3x.csv, sdc-ntc-emulator-mouser-order-3x.csv, sdc-ntc-emulator.kicad_pcb, sdc-ntc-emulator.kicad_sch]
